Wassasin/powersupply/hw/101001-powersupply/doc/psu-internal.pdf

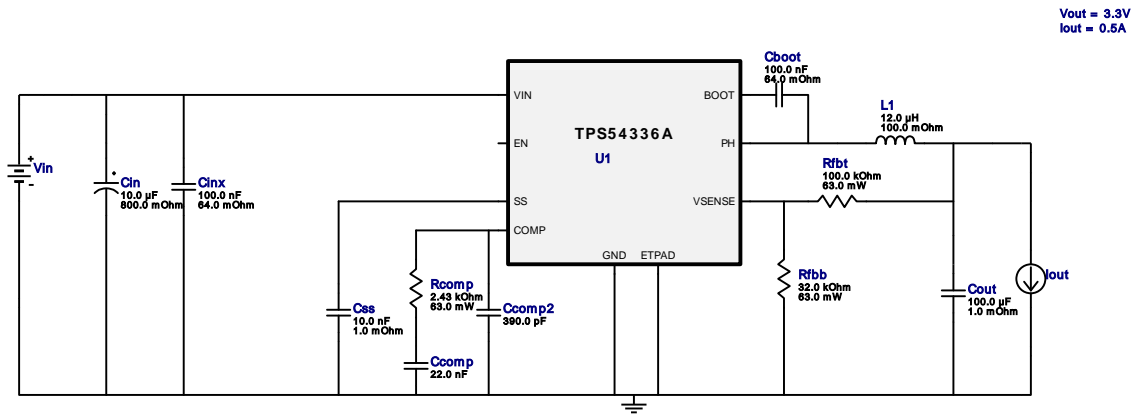
[picture p1: figure]
Rfbt 100.0 kOhm 63.0 m W; TPS5 4 3 3 6 A; VIN; BOOT; GND; VSENSE; COMP; ETPAD; L1 12.0 µH 100.0 m Ohm; Rcom p 2.43 kOhm 63.0 m W; Vout = 3.3V Iout = 0.5A; Cinx 100.0 nF 64.0 m Ohm; Cout 100.0 µF 1.0 m Ohm; Rfbb 32.0 kOhm 63.0 m W; Cboot 100.0 nF 64.0 m Ohm; Cin 10.0 µF 800.0 m Ohm; Ccom p 22.0 nF; Ccom p2; 390.0 pF Css 10.0 nF 1.0 m Ohm; Vin; Iout

Copyright © 2024, Texas Instruments Incorporated | 1 | ti.com/webench

WEBENCH®
Design Report TPS54336ADDAR : TPS54336ADDAR 5V-20V to 3.30V @ 0.5A April 9, 2024 03:35:40 GMT-05:00

## WEBENCH ® Design Report

Design : 95 TPS54336ADDAR
TPS54336ADDAR 5V-20V to 3.30V @ 0.5A

VinMin = 5.0V
VinMax = 20.0V
Vout = 3.3V
Iout = 0.5A

Device = TPS54336ADDAR
Topology = Buck
Created = 2024-04-09 03:34:54.894 BOM Cost = $1.40
BOM Count = 12
Total Pd = 0.22W

## Electrical BOM

Name | Manufacturer | Part Number | Properties | Qty Price | Footprint
Cboot | Kemet | C0805C104M5RACTU (http://capacitoredge.kemet.com/capedge2/DataSheet/Datasheet%2DC0805C104M5RACTU.pdf?pn%3DC0805C104M5RACTU) Series= X7R | Cap= 100.0 nF ESR= 64.0 mOhm VDC= 50.0 V IRMS= 1.64 A
1 | $0.01
| | | | | 0805 7 mm²
Ccomp | TDK | CGA4J2C0G1H223J125AA (http://product.tdk.com/capacitor/mlcc/en/documents/mlcc%5Fautomotive%5Fgeneral%5Fen.pdf) Series= C0G/NP0

Cap= 22.0 nF
VDC= 50.0 V
IRMS= 0.0 A

1 $0.07
0805 7 mm²
Ccomp2 | MuRata | GRM1555C1H391JA01J (http://www.murata.com/products/catalog/pdf/c02e.pdf) Series= C0G/NP0

Cap= 390.0 pF
VDC= 50.0 V
IRMS= 0.0 A

1 $0.01
0402 3 mm²
Cin | Vishay-Sprague | 293D106X0035D2TE3 (http://www.vishay.com/docs/40002/293d.pdf) Series= 293D

Cap= 10.0 uF
ESR= 800.0 mOhm
VDC= 35.0 V
IRMS= 430.0 mA

1 $0.26

7343-31 59 mm²

Cinx | Kemet | C0805C104M5RACTU (http://capacitoredge.kemet.com/capedge2/DataSheet/Datasheet%2DC0805C104M5RACTU.pdf?pn%3DC0805C104M5RACTU) Series= X7R

Cap= 100.0 nF
ESR= 64.0 mOhm
VDC= 50.0 V
IRMS= 1.64 A

1 $0.01
0805 7 mm²
Cout | MuRata | GRM32EC80J107ME20L Series= X6S

Cap= 100.0 uF
ESR= 1.0 mOhm
VDC= 6.3 V
IRMS= 6.0 A

1 $0.17
1210_270 15 mm²
Css | MuRata | GRM033R71A103KA01D (http://search.murata.co.jp/Ceramy/PnsearchViewAction.do) Series= X7R

Cap= 10.0 nF
ESR= 1.0 mOhm
VDC= 10.0 V
IRMS= 0.0 A

1 $0.01
0201 2 mm²
L1 | NIC Components | NPI54C120MTRF (http://www.niccomp.com/pn/NPI54C120MTRF) | L= 12.0 µH 100.0 mOhm
1 | $0.09

IND_NPI54C 61 mm²
Rcomp | Vishay-Dale | CRCW04022K43FKED (http://www.vishay.com/docs/20035/dcrcwe3.pdf) Series= CRCW..e3 | Res= 2.43 kOhm Power= 63.0 mW Tolerance= 1.0%
1 | $0.01
0402 3 mm²
Rfbb | Vishay-Dale | TNPW040232K0BEED (http://www.vishay.com/docs/28758/tnpw%5Fe3.pdf) Series= ? | Res= 32.0 kOhm Power= 63.0 mW Tolerance= 0.1%
1 | $0.11
0402 3 mm²

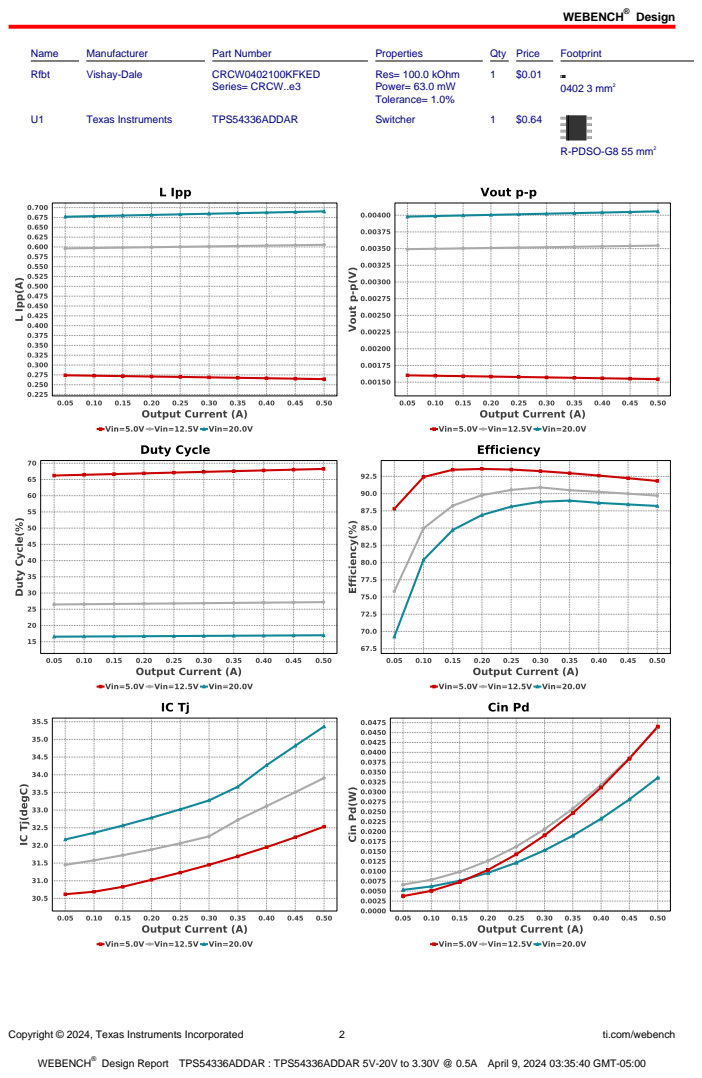
[picture p2: page 2]
Design; Copyright © 2024, Texas Instruments Incorporated; ti.com/webench; Name; Manufacturer; Part Number; Properties; Qty Price; Footprint; Rfbt; Vishay-Dale; CRCW0402100KFKED; Series= CRCW..e3; Res= 100.0 kOhm Power= 63.0 mW Tolerance= 1.0%; 0402 3 mm²; Texas Instruments; TPS54336ADDAR; Switcher; R-PDSO-G8 55 mm²

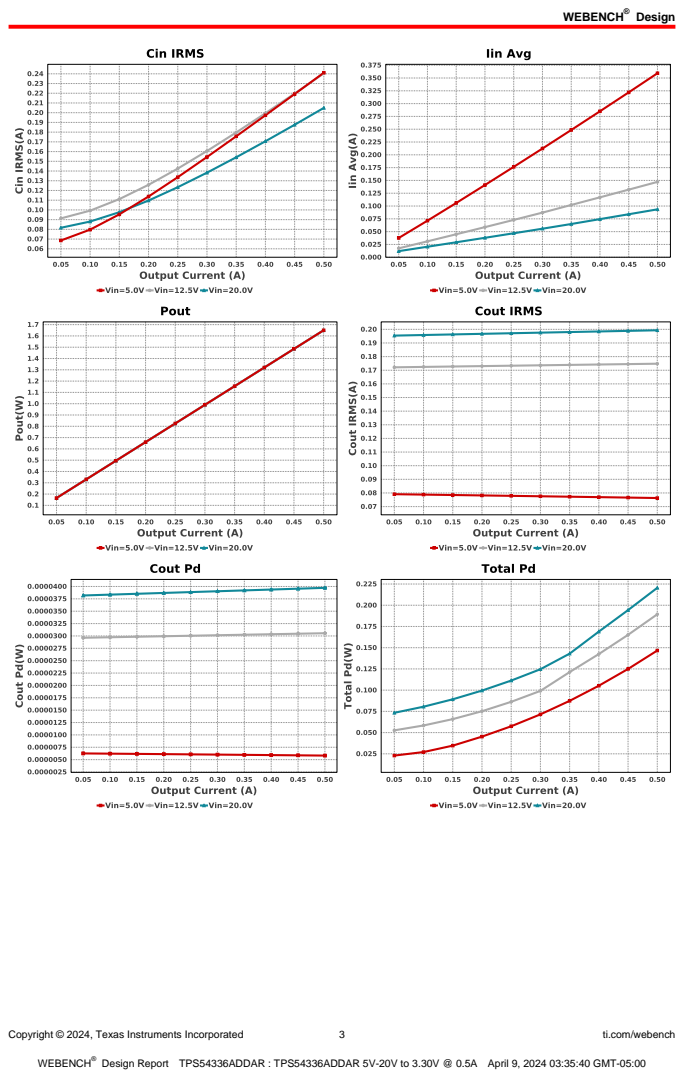
[picture p3: page 3]
Copyright © 2024, Texas Instruments Incorporated; ti.com/webench

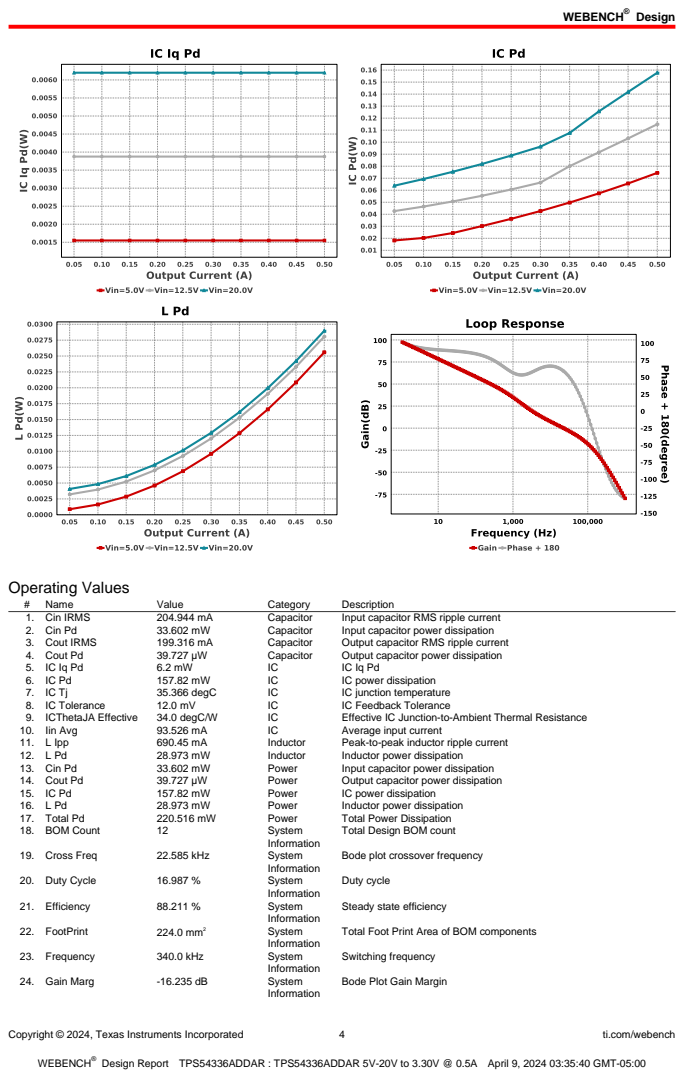
[picture p4: page 4]
Copyright © 2024, Texas Instruments Incorporated; ti.com/webench; Operating Values; Name; Value; Category; Description; 1. Cin IRMS; Capacitor; Input capacitor RMS ripple current; 2. Cin Pd; Input capacitor power dissipation; 3. Cout IRMS; Output capacitor RMS ripple current; 4. Cout Pd; Output capacitor power dissipation; IC power dissipation; 35.366 degC; IC junction temperature; 8. IC Tolerance; IC Feedback Tolerance; 9. ICThetaJA Effective; 34.0 degC/W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

Total Design BOM count

Bode plot crossover frequency

Steady state efficiency

Total Foot Print Area of BOM components

Bode Plot Gain Margin

Copyright © 2024, Texas Instruments Incorporated | 5 | ti.com/webench
# | Name | Value | Category | Description

25. Iout | 500.0 mA | System
| | | Information | Iout operating point
26. Low Freq Gain | 97.437 dB | System
| | | Information | Gain at 1Hz
27. Mode | CCM | System
| | | Information | Conduction Mode
28. Phase Marg | 59.525 deg | System
| | | Information | Bode Plot Phase Margin
29. Pout | 1.65 W | System
| | | Information | Total output power
30. Total BOM | $1.4 | System
| | | Information | Total BOM Cost
31. Vin | 20.0 V | System
| | | Information | Vin operating point
32. Vout | 3.3 V | System
| | | Information | Operational Output Voltage
33. Vout Actual | 3.3 V | System
| | | Information | Vout Actual calculated based on selected voltage divider resistors
34. Vout Tolerance | 2.347 % | System
| | | Information | Vout Tolerance based on IC Tolerance (no load) and voltage divider resistors if applicable
35. Vout p-p | 4.057 mV | System
| | | Information | Peak-to-peak output ripple voltage

## Design Inputs

Name | Value | Description
| Iout | | 500.0 m | Maximum Output Current
VinMax | 20.0 | Maximum input voltage
VinMin | 5.0 | Minimum input voltage
Vout | 3.3 | Output Voltage
| base_pn | | TPS54336A | Base Product Number
source | DC | Input Source Type
Ta | 30.0 | Ambient temperature


Copyright © 2024, Texas Instruments Incorporated | 6 | ti.com/webench

## Assembly

## Component Testing

Some published data on components in datasheets such as Capacitor ESR and Inductor DC resistance is based on conservative values that will guarantee that the components always exceed the specification. For design purposes it is usually better to work with typical values. Since this data is not always available it is a good practice to measure the Capacitance and ESR values of Cin and Cout, and the inductance and DC resistance of L1 before assembly of the board. Any large discrepancies in values should be electrically simulated in WEBENCH to check for instabilities and thermally simulated in WebTHERM to make sure critical temperatures are not exceeded.

## Soldering Component to Board

If board assembly is done in house it is best to tack down one terminal of a component on the board then solder the other terminal. For surface mount parts with large tabs, such as the DPAK, the tab on the back of the package should be pre-tinned with solder, then tacked into place by one of the pins. To solder the tab town to the board place the iron down on the board while resting against the tab, heating both surfaces simultaneously. Apply light pressure to the top of the plastic case until the solder flows around the part and the part is flush with the PCB. If the solder is not flowing around the board you may need a higher wattage iron (generally 25W to 30W is enough).

## Initial Startup of Circuit

It is best to initially power up the board by setting the input supply voltage to the lowest operating input voltage 5.0V and set the input supply's current limit to zero. With the input supply off connect up the input supply to Vin and GND. Connect a digital volt meter and a load if needed to set the minimum Iout of the design from Vout and GND. Turn on the input supply and slowly turn up the current limit on the input supply. If the voltage starts to rise on the input supply continue increasing the input supply current limit while watching the output voltage. If the current increases on the input supply, but the voltage remains near zero, then there may be a short or a component misplaced on the board. Power down the board and visually inspect for solder bridges and recheck the diode and capacitor polarities. Once the power supply circuit is operational then more extensive testing may include full load testing, transient load and line tests to compare with simulation results.

## Load Testing

The setup is the same as the initial startup, except that an additional digital voltmeter is connected between Vin and GND, a load is connected between Vout and GND and a current meter is connected in series between Vout and the load. The load must be able to handle at least rated output power + 50% ( 7.5 watts for this design). Ideally the load is supplied in the form of a variable load test unit. It can also be done in the form of suitably large power resistors. When using an oscilloscope to measure waveforms on the prototype board, the ground leads of the oscilloscope probes should be as short as possible and the area of the loop formed by the ground lead should be kept to a minimum. This will help reduce ground lead inductance and eliminate EMI noise that is not actually present in the circuit.

## Design Assistance

1. Master key : 7E00AF9B0638DEC2[v1]
2. TPS54336A Product Folder : http://www.ti.com/product/TPS54336A : contains the data sheet and other resources.

Copyright © 2024, Texas Instruments Incorporated | 7 | ti.com/webench

Important Notice and Disclaimer

TI provides technical and reliability data (including datasheets), design resources (including reference designs), application or other design advice, web tools, safety information, and other resources AS IS and with all faults, and disclaims all warranties. These resources are intended for skilled developers designing with TI products. You are solely responsible for (1) selecting the appropriate TI products for your application, (2) designing, validating and testing your application, and (3) ensuring your application meets applicable standards, and any other safety, security, or other requirements.

These resources are subject to change without notice. TI grants you permission to use these resources only for development of an application that uses the TI products described in the resource. Other reproduction and display of these resources is prohibited. No license is granted to any other TI intellectual property right or to any third party intellectual property right. TI disclaims responsibility for, and you will fully indemnify TI and its representatives against, any claims, damages, costs, losses, and liabilities arising out of your use of these resources.

Providing these resources does not expand or otherwise alter TI's applicable Terms of Sale or other applicable terms available either on ti.com or provided in conjunction with TI products.
