Wassasin/powersupply/hw/101001-powersupply/101001-powersupply.kicad_pcb

## KiCad design hw/101001-powersupply/101001-powersupply.kicad_pcb (2024-06-27)

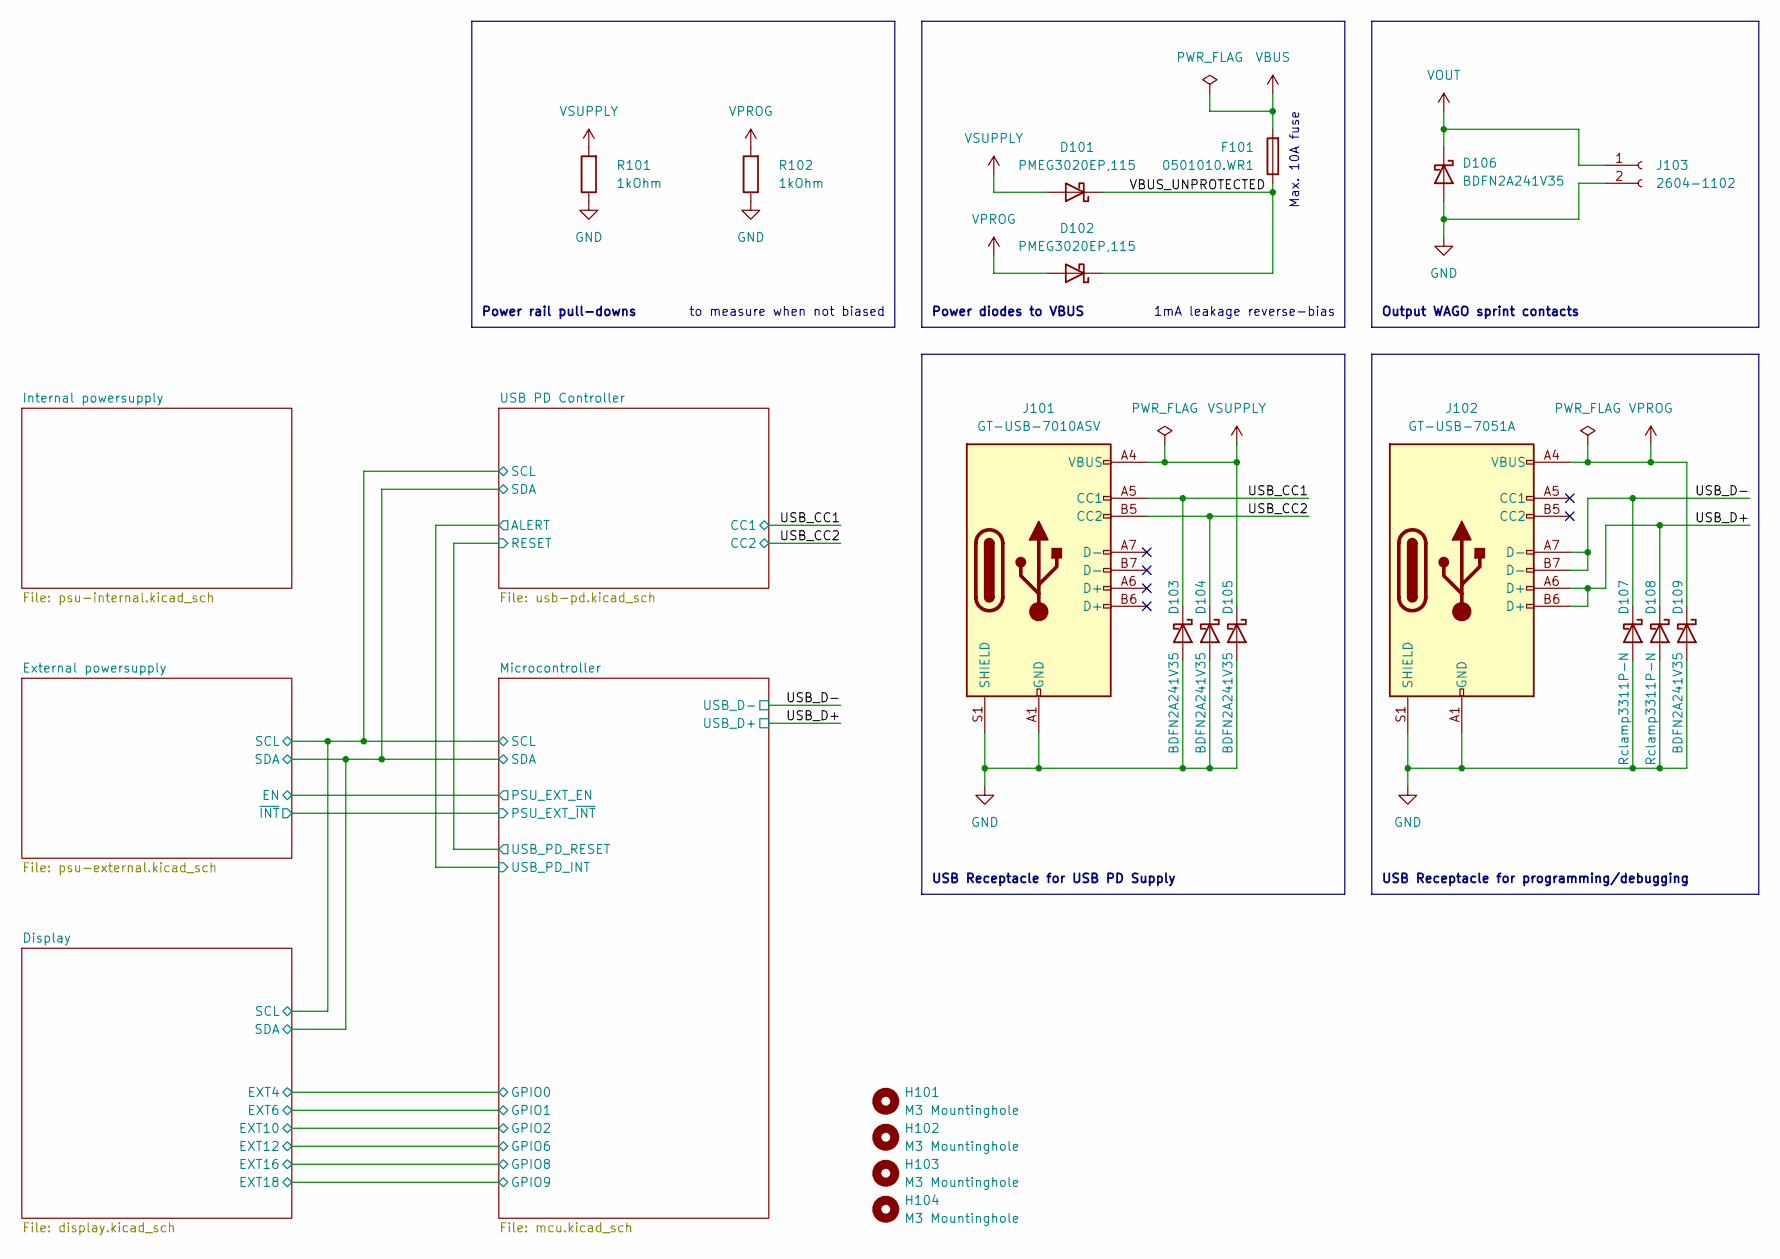
[picture p11: schematic 101001-powersupply.kicad_sch, Variable USB power supply]

Parts:
D101, D102: PMEG3020EP,115; D_SOD-128; LCSC C513108
D103, D104, D105, D106, D109: BDFN2A241V35; D_SOD-882; LCSC C406193
D107, D108: Rclamp3311P-N; D_SOD-882; LCSC C406234
F101: 0501010.WR1; Fuse_1206_3216Metric; LCSC C207003
H101, H102, H103, H104: M3 Mountinghole; MountingHole_3.2mm_M3
J101: GT-USB-7010ASV; USB_C_Receptacle_G-Switch_GT-USB-7010ASV; LCSC C2988369
J102: GT-USB-7051A; USB_C_Receptacle_G-Switch_GT-USB-7051x; LCSC C2843970
J103: 2604-1102; WAGO-2604-1102
R101, R102: 1kOhm; R_0402_1005Metric; LCSC C11702

Connections:
/USB_CC1: D103.1 (K), J101.A5 (CC1); also elsewhere on the board
/USB_CC2: D104.1 (K), J101.B5 (CC2); also elsewhere on the board
/USB_D+: D108.1 (K), J102.A6 (D+), J102.B6 (D+); also elsewhere on the board
/USB_D-: D107.1 (K), J102.A7 (D-), J102.B7 (D-); also elsewhere on the board
/VBUS_UNPROTECTED: D101.1 (K), D102.1 (K), F101.1
VBUS: F101.2; also elsewhere on the board
VOUT: D106.1 (K), J103.1; also elsewhere on the board
VPROG: D102.2 (A), D109.1 (K), J102.A4 (VBUS), J102.A9 (VBUS), J102.B4 (VBUS), J102.B9 (VBUS), R102.2; also elsewhere on the board
VSUPPLY: D101.2 (A), D105.1 (K), J101.A4 (VBUS), J101.A9 (VBUS), J101.B4 (VBUS), J101.B9 (VBUS), R101.2; also elsewhere on the board

Notes on the sheet:
to measure when not biased
Max. 10A fuse
Power rail pull-downs
USB Receptacle for programming/debugging
USB Receptacle for USB PD Supply
1mA leakage reverse-bias
Power diodes to VBUS
Output WAGO sprint contacts

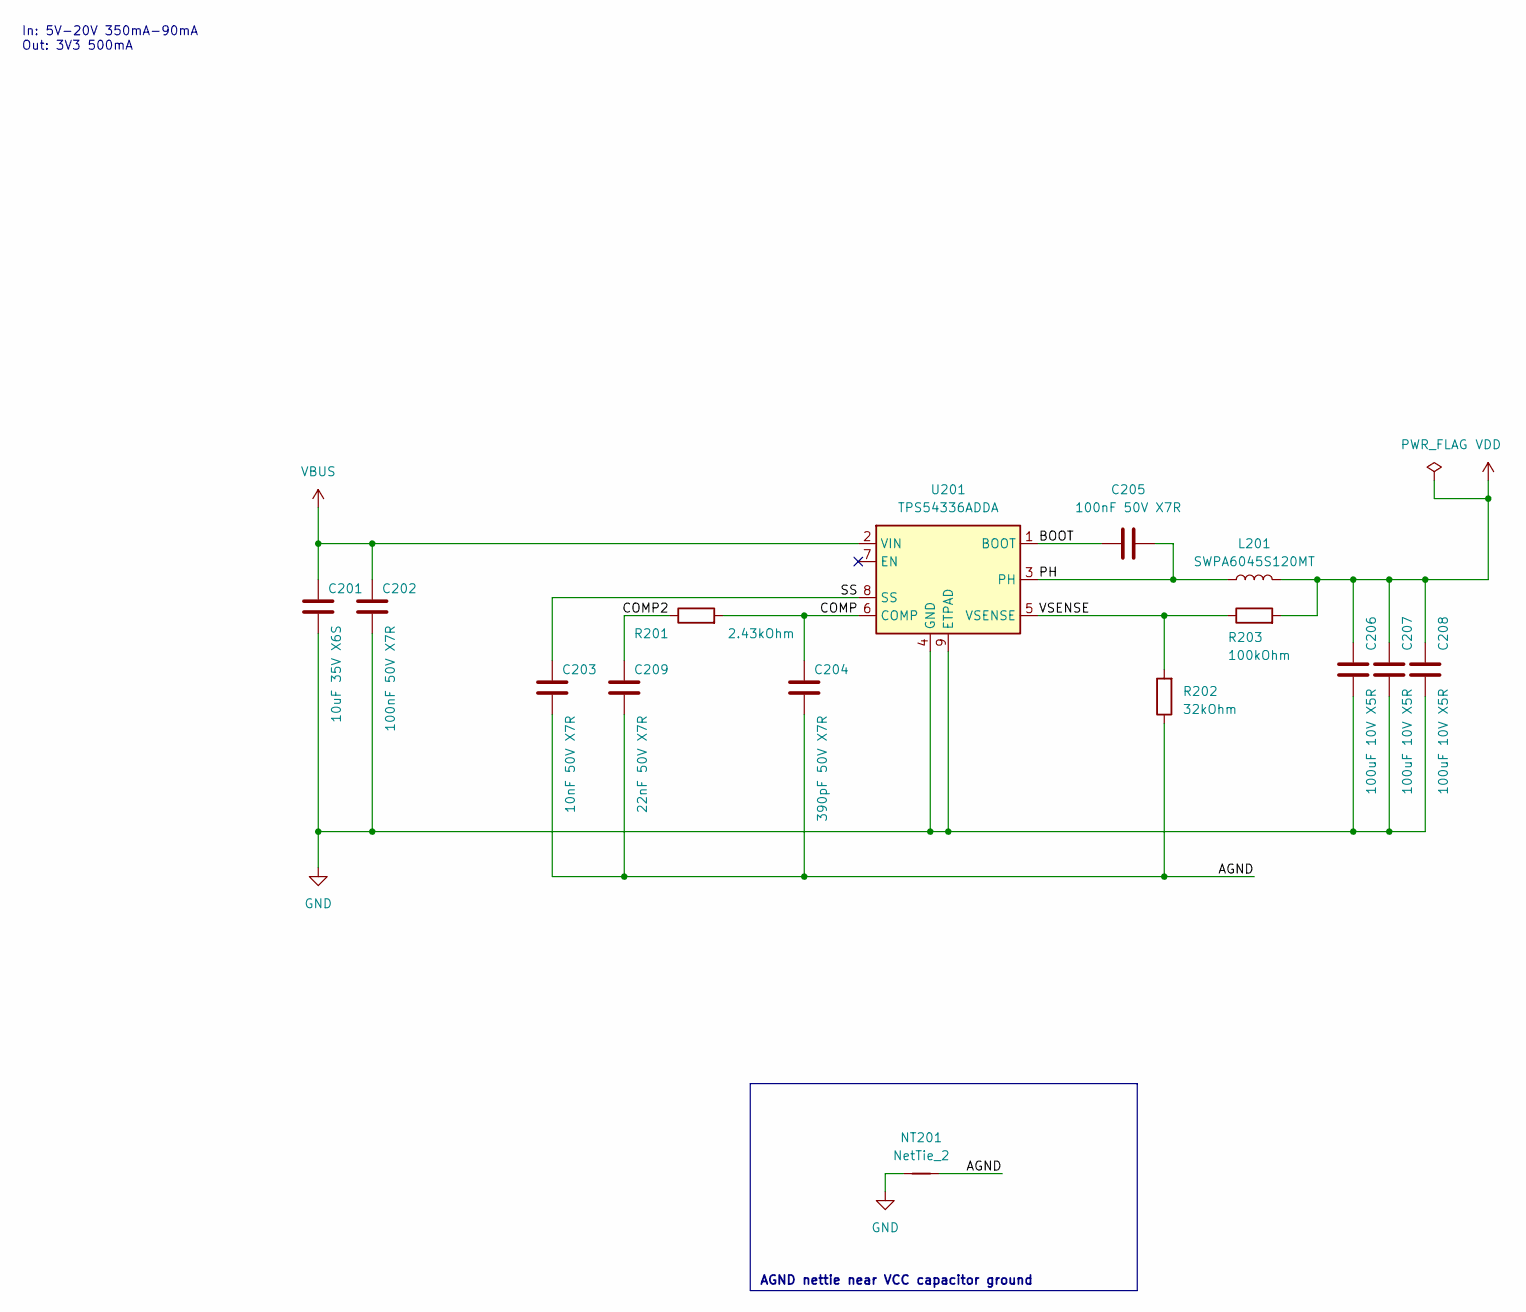
[picture p12: schematic psu-internal.kicad_sch, Variable USB power supply]

Parts:
C201: 10uF 35V X6S; C_0805_2012Metric; MPN GRM21BC8YA106KE11L; LCSC C469541
C202, C205: 100nF 50V X7R; C_0402_1005Metric; MPN CL05B104KB54PNC; LCSC C307331
C203: 10nF 50V X7R; C_0402_1005Metric; MPN CL05B103KB5NNNC; LCSC C15195
C204: 390pF 50V X7R; C_0402_1005Metric; MPN CC0402KRX7R9BB391; LCSC C114397
C206, C207, C208: 100uF 10V X5R; C_1206_3216Metric; MPN GRM31CR61A107ME05L; LCSC C312983
C209: 22nF 50V X7R; C_0402_1005Metric; MPN CL05B223KB5NNNC; LCSC C337699
L201: SWPA6045S120MT; L_Sunlord_SWPA6045S; MPN SWPA6045S120MT; LCSC C96951
NT201: NetTie_2; NetTie-2_SMD_Pad0.5mm
R201: 2.43kOhm; R_0402_1005Metric; LCSC C853891
R202: 32kOhm; R_0402_1005Metric; LCSC C11463
R203: 100kOhm; R_0402_1005Metric; LCSC C25741
U201: TPS54336ADDA; TI_SO-PowerPAD-8_ThermalVias; MPN TPS54336ADDA; LCSC C97668

Connections:
/Internal powersupply/AGND: C203.2, C204.2, C209.2, NT201.2, R202.1
/Internal powersupply/BOOT: C205.1, U201.1 (BOOT)
/Internal powersupply/COMP: C204.1, R201.2, U201.6 (COMP)
/Internal powersupply/COMP2: C209.1, R201.1
/Internal powersupply/PH: C205.2, L201.1, U201.3 (PH)
/Internal powersupply/SS: C203.1, U201.8 (SS)
/Internal powersupply/VSENSE: R202.2, R203.1, U201.5 (VSENSE)
VBUS: C201.1, C202.1, U201.2 (VIN); also elsewhere on the board
VDD: C206.1, C207.1, C208.1, L201.2, R203.2; also elsewhere on the board

Notes on the sheet:
In: 5V-20V 350mA-90mA Out: 3V3 500mA
AGND nettie near VCC capacitor ground

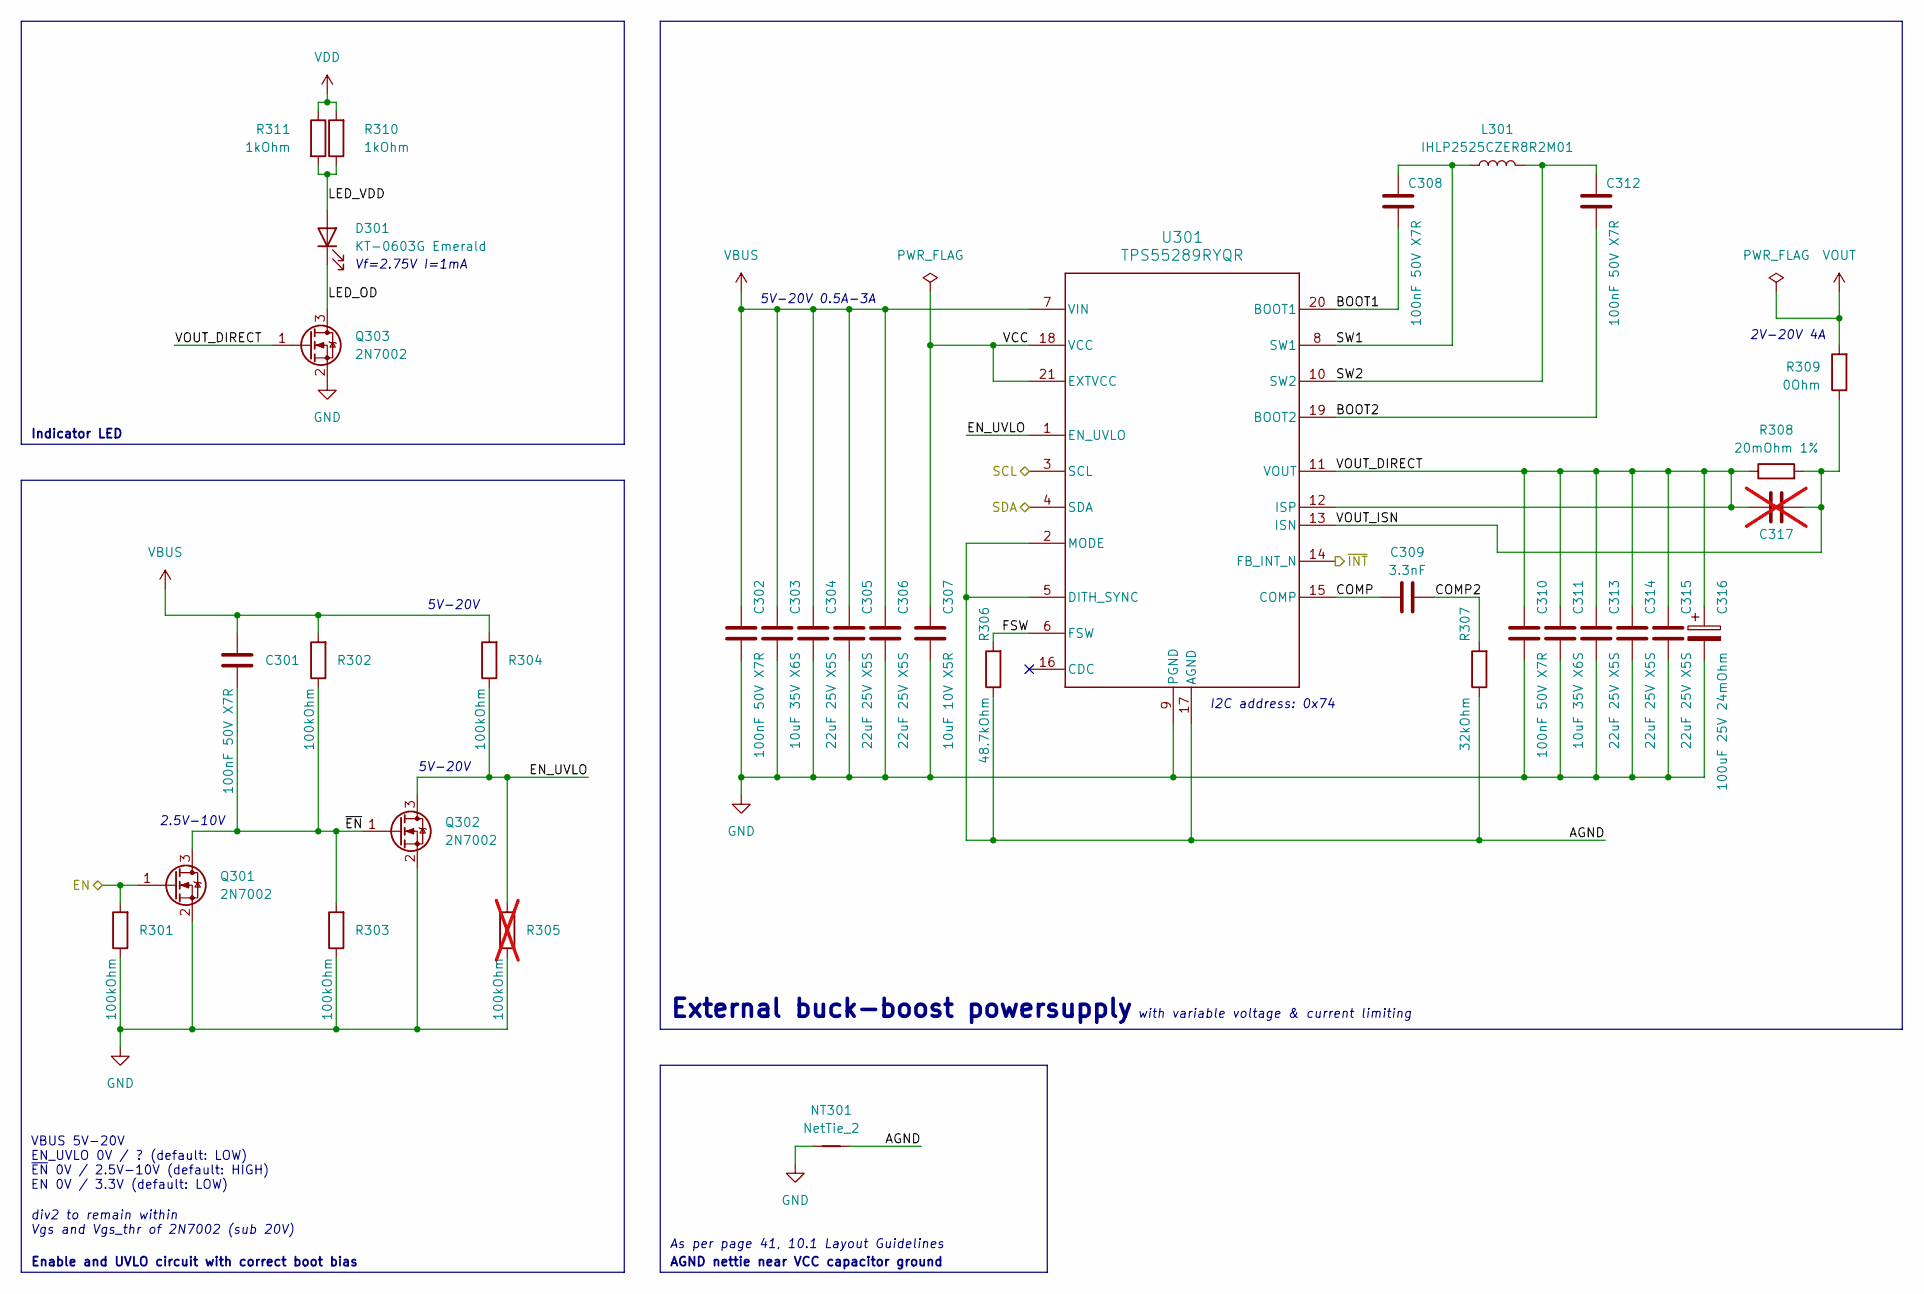
[picture p13: schematic psu-external.kicad_sch, Variable USB power supply]

Parts:
C301, C302, C308, C310, C312: 100nF 50V X7R; C_0402_1005Metric; MPN CL05B104KB54PNC; LCSC C307331
C303, C311: 10uF 35V X6S; C_0805_2012Metric; MPN GRM21BC8YA106KE11L; LCSC C469541
C304, C305, C306, C313, C314, C315: 22uF 25V X5S; C_1210_3225Metric; MPN GRM32ER71E226KE15L; LCSC C21397
C307: 10uF 10V X5R; C_0402_1005Metric; MPN GRM155R61A106ME11D; LCSC C408132
C309: 3.3nF; C_0402_1005Metric; MPN CC0402KRX7R9BB332; LCSC C107028
C316: 100uF 25V 24mOhm; CP_Elec_8x6.9; MPN 25SVPF100M; LCSC C136279
C317: C_0402_1005Metric; MPN CL05B104KB54PNC; LCSC C307331; not fitted
D301: KT-0603G Emerald; LED_0603_1608Metric; LCSC C12624
L301: IHLP2525CZER8R2M01; L_Vishay_IHLP-2525; MPN IHLP2525CZER8R2M01; LCSC C506576
NT301: NetTie_2; NetTie-2_SMD_Pad0.5mm
Q301, Q302, Q303: 2N7002; SOT-23; LCSC C8545
R301, R302, R303, R304: 100kOhm; R_0402_1005Metric; LCSC C25741
R305: 100kOhm; R_0402_1005Metric; LCSC C25741; not fitted
R306: 48.7kOhm; R_0402_1005Metric; LCSC C26981
R307: 32kOhm; R_0402_1005Metric; LCSC C11463
R308: 20mOhm 1%; R_2512_6332Metric; LCSC C2903469
R309: 0Ohm; R_2512_6332Metric; LCSC C25469
R310, R311: 1kOhm; R_0402_1005Metric; LCSC C11702
U301: TPS55289RYQR; Texas_RYQ0021A_VQFN-21_P0.5mm_EP5.0x3.0mm

Connections:
/Display/SCL: U301.3 (SCL); also elsewhere on the board
/Display/SDA: U301.4 (SDA); also elsewhere on the board
/External powersupply/AGND: NT301.2, R306.1, R307.1, U301.2 (MODE), U301.5 (DITH_SYNC), U301.17 (AGND)
/External powersupply/BOOT1: C308.2, U301.20 (BOOT1)
/External powersupply/BOOT2: C312.2, U301.19 (BOOT2)
/External powersupply/COMP: C309.1, U301.15 (COMP)
/External powersupply/COMP2: C309.2, R307.2
/External powersupply/EN: Q301.1 (G), R301.2; also elsewhere on the board
/External powersupply/EN_UVLO: Q302.3 (D), R304.1, R305.2, U301.1 (EN_UVLO)
/External powersupply/FSW: R306.2, U301.6 (FSW)
/External powersupply/LED_OD: D301.1 (K), Q303.3 (D)
/External powersupply/LED_VDD: D301.2 (A), R310.1, R311.2
/External powersupply/SW1: C308.1, L301.1, U301.8 (SW1)
/External powersupply/SW2: C312.1, L301.2, U301.10 (SW2)
/External powersupply/VCC: C307.1, U301.18 (VCC), U301.21 (EXTVCC)
/External powersupply/VOUT_DIRECT: C310.1, C311.1, C313.1, C314.1, C315.1, C316.1, C317.1, Q303.1 (G), R308.1, U301.11 (VOUT), U301.12 (ISP)
/External powersupply/VOUT_ISN: C317.2, R308.2, R309.1, U301.13 (ISN)
/External powersupply/~EN: C301.2, Q301.3 (D), Q302.1 (G), R302.1, R303.2
/External powersupply/~INT: U301.14 (FB_INT_N); also elsewhere on the board
VBUS: C301.1, C302.1, C303.1, C304.1, C305.1, C306.1, R302.2, R304.2, U301.7 (VIN); also elsewhere on the board
VDD: R310.2, R311.1; also elsewhere on the board
VOUT: R309.2; also elsewhere on the board

Notes on the sheet:
div2 to remain within Vgs and Vgs_thr of 2N7002 (sub 20V)
with variable voltage & current limiting
Vf=2.75V I=1mA
5V-20V
I2C address: 0x74
VBUS 5V-20V EN_UVLO 0V / ? (default: LOW) ~{EN} 0V / 2.5V-10V (default: HIGH) EN 0V / 3.3V (default: LOW)
As per page 41, 10.1 Layout Guidelines
Indicator LED
2.5V-10V
2V-20V 4A
5V-20V 0.5A-3A
AGND nettie near VCC capacitor ground
Enable and UVLO circuit with correct boot bias
External buck-boost powersupply

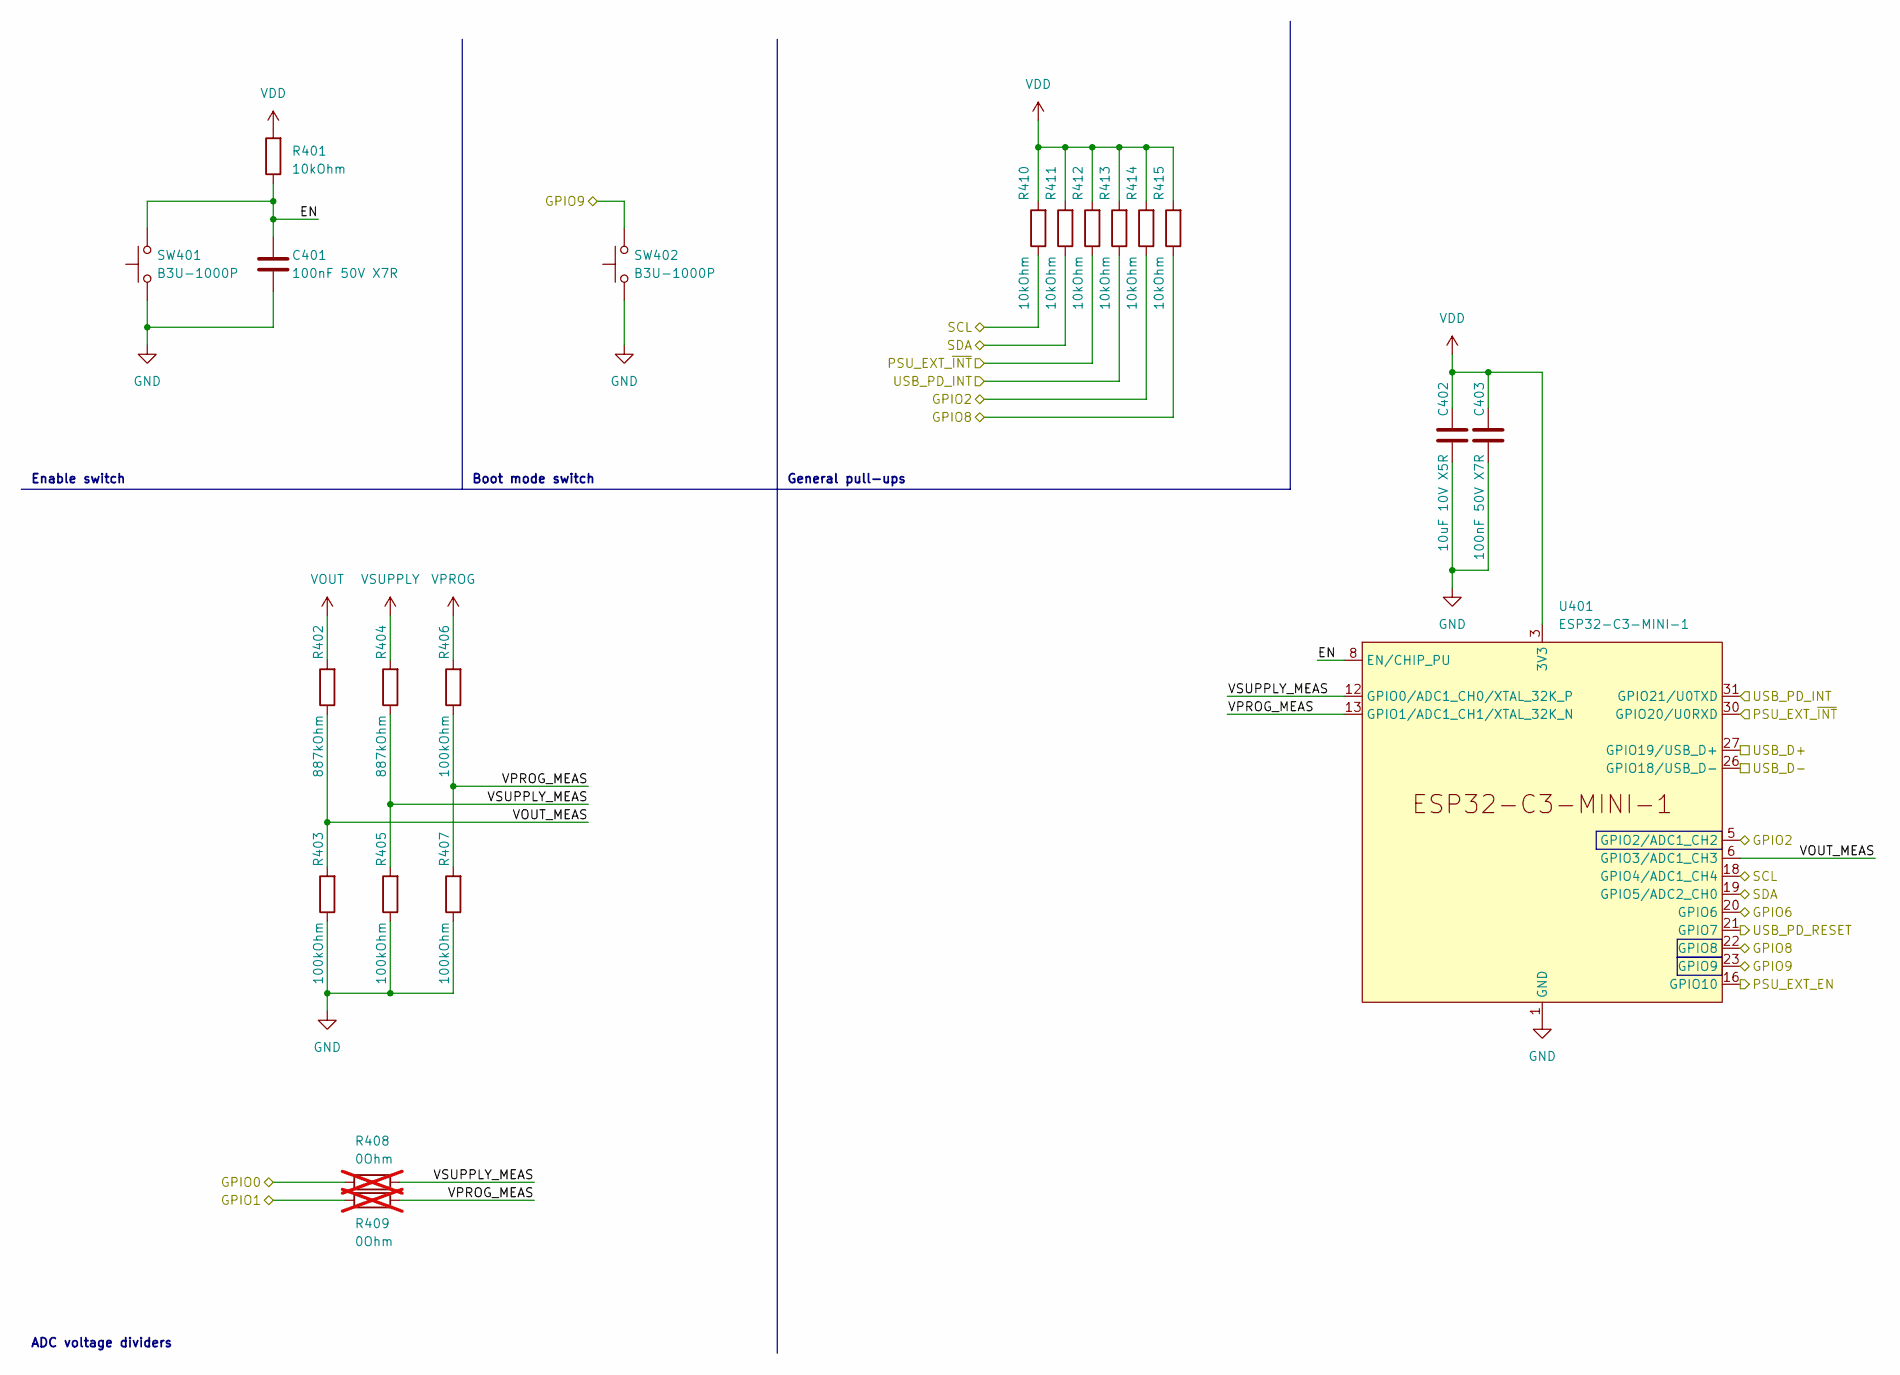
[picture p14: schematic mcu.kicad_sch, Variable USB power supply]

Parts:
C401, C403: 100nF 50V X7R; C_0402_1005Metric; MPN CL05B104KB54PNC; LCSC C307331
C402: 10uF 10V X5R; C_0402_1005Metric; MPN GRM155R61A106ME11D; LCSC C408132
R401, R410, R411, R412, R413, R414, R415: 10kOhm; R_0402_1005Metric; LCSC C60490
R402, R404: 887kOhm; R_0402_1005Metric; LCSC C137930
R403, R405, R406, R407: 100kOhm; R_0402_1005Metric; LCSC C25741
R408, R409: 0Ohm; R_0402_1005Metric; not fitted
SW401, SW402: B3U-1000P; SW_SPST_B3U-1000P; LCSC C231329
U401: ESP32-C3-MINI-1

Connections:
/Display/EXT4: R408.1; also elsewhere on the board
/Display/EXT6: R409.2; also elsewhere on the board
/Display/EXT10: R414.1, U401.5 (GPIO2/ADC1_CH2); also elsewhere on the board
/Display/EXT12: U401.20 (GPIO6); also elsewhere on the board
/Display/EXT16: R415.1, U401.22 (GPIO8); also elsewhere on the board
/Display/EXT18: SW402.2, U401.23 (GPIO9); also elsewhere on the board
/Display/SCL: R410.1, U401.18 (GPIO4/ADC1_CH4); also elsewhere on the board
/Display/SDA: R411.1, U401.19 (GPIO5/ADC2_CH0); also elsewhere on the board
/External powersupply/EN: U401.16 (GPIO10); also elsewhere on the board
/External powersupply/~INT: R412.1, U401.30 (GPIO20/U0RXD); also elsewhere on the board
/Microcontroller/EN: C401.2, R401.1, SW401.2, U401.8 (EN/CHIP_PU)
/Microcontroller/USB_PD_INT: R413.1, U401.31 (GPIO21/U0TXD); also elsewhere on the board
/Microcontroller/USB_PD_RESET: U401.21 (GPIO7); also elsewhere on the board
/Microcontroller/VOUT_MEAS: R402.1, R403.2, U401.6 (GPIO3/ADC1_CH3)
/Microcontroller/VPROG_MEAS: R406.1, R407.2, R409.1, U401.13 (GPIO1/ADC1_CH1/XTAL_32K_N)
/Microcontroller/VSUPPLY_MEAS: R404.1, R405.2, R408.2, U401.12 (GPIO0/ADC1_CH0/XTAL_32K_P)
/USB_D+: U401.27 (GPIO19/USB_D+); also elsewhere on the board
/USB_D-: U401.26 (GPIO18/USB_D-); also elsewhere on the board
VDD: C402.1, C403.1, R401.2, R410.2, R411.2, R412.2, R413.2, R414.2, R415.2, U401.3 (3V3); also elsewhere on the board
VOUT: R402.2; also elsewhere on the board
VPROG: R406.2; also elsewhere on the board
VSUPPLY: R404.2; also elsewhere on the board

Notes on the sheet:
Enable switch
ADC voltage dividers
General pull-ups
Boot mode switch

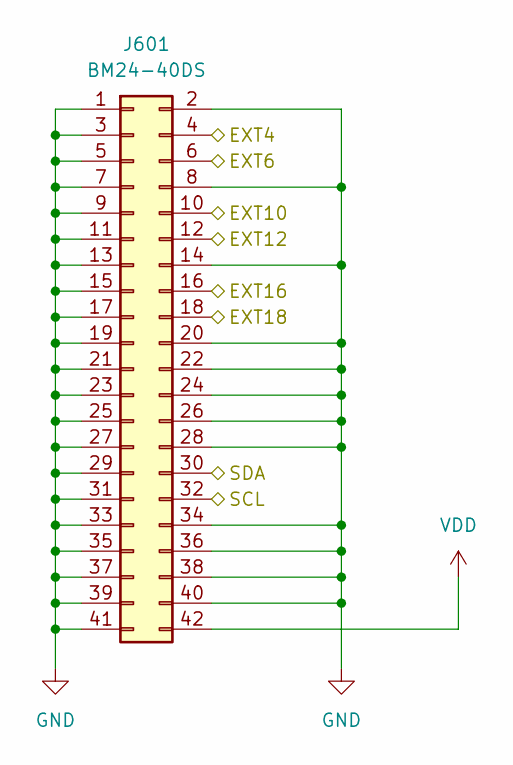
[picture p15: schematic display.kicad_sch, Variable USB power supply]

Parts:
J601: BM24-40DS; Hirose_BM24_BM24-40DS-2-0.35V_2x20_P0.35mm_PowerPin2_Vertic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; MPN BM24-40DS/2-0.35V(51); LCSC C424559

Connections:
/Display/EXT4: J601.4; also elsewhere on the board
/Display/EXT6: J601.6; also elsewhere on the board
/Display/EXT10: J601.10; also elsewhere on the board
/Display/EXT12: J601.12; also elsewhere on the board
/Display/EXT16: J601.16; also elsewhere on the board
/Display/EXT18: J601.18; also elsewhere on the board
/Display/SCL: J601.32; also elsewhere on the board
/Display/SDA: J601.30; also elsewhere on the board
VDD: J601.42; also elsewhere on the board

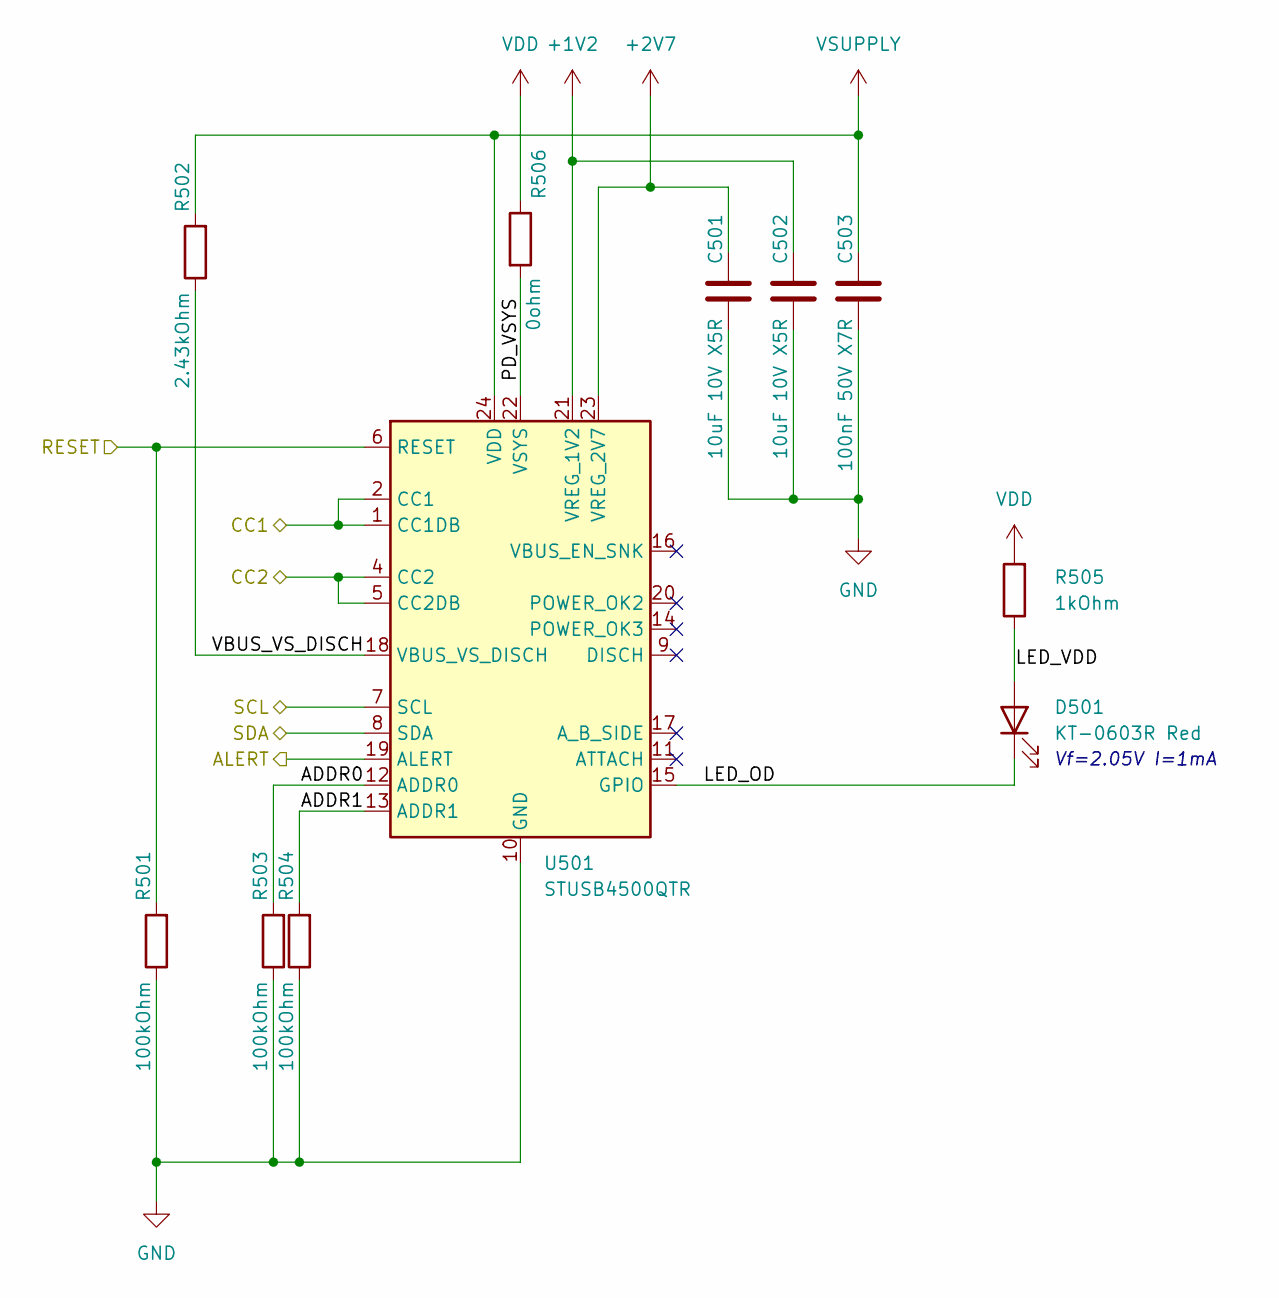
[picture p16: schematic usb-pd.kicad_sch, Variable USB power supply]

Parts:
C501, C502: 10uF 10V X5R; C_0402_1005Metric; MPN GRM155R61A106ME11D; LCSC C408132
C503: 100nF 50V X7R; C_0402_1005Metric; MPN CL05B104KB54PNC; LCSC C307331
D501: KT-0603R Red; LED_0603_1608Metric; LCSC C2286
R501, R503, R504: 100kOhm; R_0402_1005Metric; LCSC C25741
R502: 2.43kOhm; R_0402_1005Metric; LCSC C853891
R505: 1kOhm; R_0402_1005Metric; LCSC C11702
R506: 0ohm; R_0402_1005Metric; LCSC C2906877
U501: STUSB4500QTR; QFN-24-1EP_4x4mm_P0.5mm_EP2.7x2.7mm; LCSC C2678061

Connections:
+1V2: C502.1, U501.21 (VREG_1V2)
+2V7: C501.1, U501.23 (VREG_2V7)
/Display/SCL: U501.7 (SCL); also elsewhere on the board
/Display/SDA: U501.8 (SDA); also elsewhere on the board
/Microcontroller/USB_PD_INT: U501.19 (ALERT); also elsewhere on the board
/Microcontroller/USB_PD_RESET: R501.2, U501.6 (RESET); also elsewhere on the board
/USB PD Controller/ADDR0: R503.2, U501.12 (ADDR0)
/USB PD Controller/ADDR1: R504.2, U501.13 (ADDR1)
/USB PD Controller/LED_OD: D501.1 (K), U501.15 (GPIO)
/USB PD Controller/LED_VDD: D501.2 (A), R505.1
/USB PD Controller/VBUS_VS_DISCH: R502.1, U501.18 (VBUS_VS_DISCH)
/USB_CC1: U501.1 (CC1DB), U501.2 (CC1); also elsewhere on the board
/USB_CC2: U501.4 (CC2), U501.5 (CC2DB); also elsewhere on the board
VDD: R505.2, R506.1; also elsewhere on the board
VSUPPLY: C503.1, R502.2, U501.24 (VDD); also elsewhere on the board

Notes on the sheet:
Vf=2.05V I=1mA

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
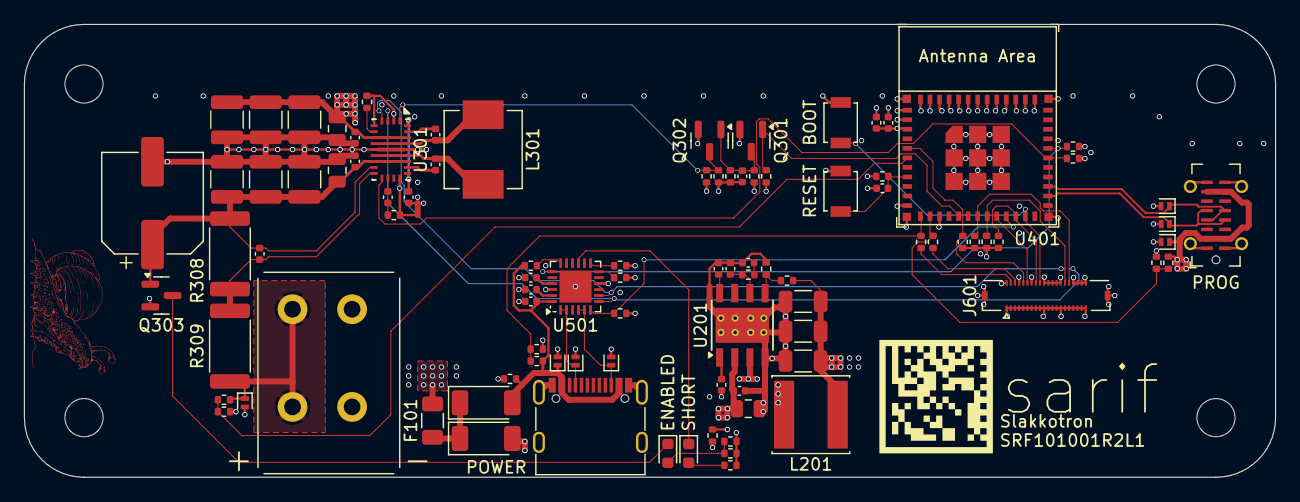
[picture p17: board 101001-powersupply.kicad_pcb from above]

Board: 6 copper layers, 105.0 x 38.0 mm, 101 parts (0 on the bottom side), 56 nets.
