Wassasin/powersupply/sw/fw/nvm_basic.h

// STUSBxx - NVM memory map 

uint8_t Sector0[8] = {0x00,0x00,0xB0,0xAB,0x00,0x45,0x00,0x00};
uint8_t Sector1[8] = {0x00,0x40,0x9C,0x1C,0xFF,0x01,0x3C,0xDF};
uint8_t Sector2[8] = {0x02,0x40,0x0F,0x00,0x32,0x00,0xFC,0xF1};
uint8_t Sector3[8] = {0x00,0x19,0x50,0xAF,0xF5,0x35,0x5F,0x00};
uint8_t Sector4[8] = {0x00,0x4B,0x90,0x21,0x43,0x00,0x40,0xFB};
