Wassasin/powersupply/(commit log)

2024-04-23 Added initial sketch
    [101001-powersupply.kicad_pcb, 101001-powersupply.kicad_sch, display.kicad_sch, mcu.kicad_sch, psu-external.kicad_sch, psu-internal.kicad_sch, usb-pd.kicad_sch]
2024-04-23 Progress on board design
    [101001-powersupply.kicad_pcb, 101001-powersupply.kicad_sch, display.kicad_sch, mcu.kicad_sch, psu-external.kicad_sch, psu-internal.kicad_sch, usb-pd.kicad_sch]
2024-04-24 Finalized board design
    [101001-powersupply.kicad_pcb, 101001-powersupply.kicad_sch, psu-external.kicad_sch, psu-internal.kicad_sch, usb-pd.kicad_sch]
2024-06-19 Fixed Ccomp
    [101001-powersupply.kicad_pcb, 101001-powersupply.kicad_sch, display.kicad_sch, mcu.kicad_sch, psu-external.kicad_sch, psu-internal.kicad_sch, usb-pd.kicad_sch]
2024-06-19 Added strapping pins bias and buttons
    [101001-powersupply.kicad_pcb, mcu.kicad_sch]
2024-06-24 Added TPS55289 driver
2024-06-27 Hardware improvements
    [101001-powersupply.kicad_pcb, 101001-powersupply.kicad_sch, psu-external.kicad_sch, usb-pd.kicad_sch]
2024-07-02 Make power_ext use configuration system
2024-07-03 Fix USB-PD with no programmer connection
    [main.rs, rev1.rs, usb_pd.rs]
2024-07-03 Fixed clippy issues; added backoff propagation
    [config.rs, events.rs, hl.rs, ll.rs, logger.rs, main.rs, mod.rs, net.rs]
2024-07-04 Added fork of executor to keep track of idle time
